LuisFelipe2204/camara-fenotipado/docs/FlowDiagram.png

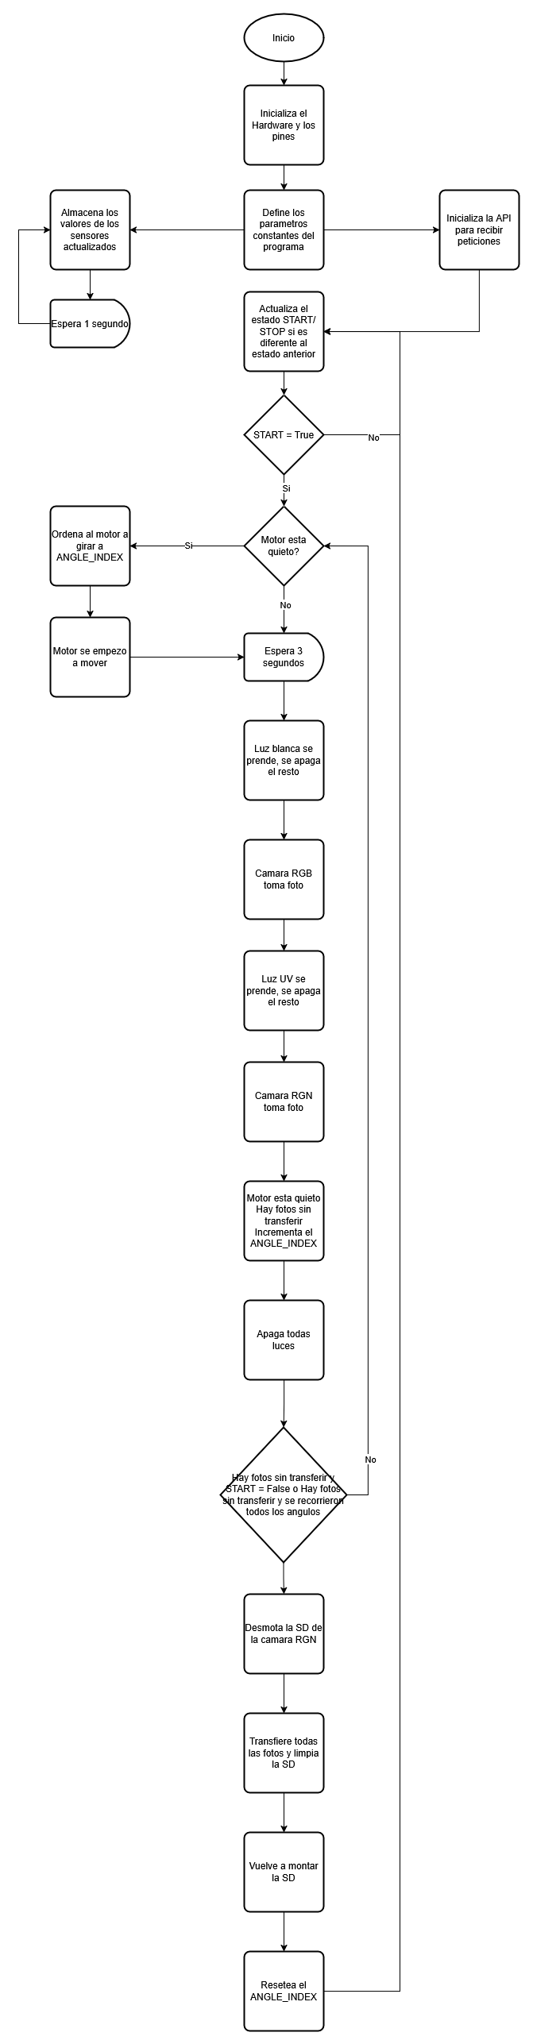
docs/FlowDiagram.png
