LuisFelipe2204/camara-fenotipado/(list of files, drawings)

Other design files:
docs/schema/Schema-V1.pdsprj
docs/schema/Schema.pdsprj
