LuisFelipe2204/camara-fenotipado/backend/modules/survey3.py

import logging
import shutil
import time
from os import listdir, path, remove

import digitalio

from utils import generate_photo_name, get_session_dirpath, safe_copy

logging.basicConfig(
    format=(
        "\033[90m%(asctime)s\033[0m "
        + "[\033[36m%(levelname)s\033[0m] "
        + "[\033[33m%(module)s::%(funcName)s\033[0m] "
        + "%(message)s"
    ),
    datefmt="%Y-%m-%d %H:%M:%S",
    level=logging.INFO,
    handlers=[logging.StreamHandler()],
)


class Pulse:
    DO_NOTHING = 0.001
    TAKE_PHOTO = 0.002
    TRANSFER = 0.0015


class Survey3:
    def __init__(self, pin: digitalio.DigitalInOut, cam_id: str, origin: str, dest: str):
        self.pin = pin
        self.origin = origin
        self.dest = dest
        self.id = cam_id
        self.pin.direction = digitalio.Direction.OUTPUT
        self.pin.value = False
        self.set_mount(True)

    def set_mount(self, to_mount: bool):
        # When to_mount is True, it ensures the SD becomes not accessible
        origin_exists = path.isdir(self.origin)
        # Mounted means the origin path should not be accessible
        if to_mount and origin_exists:
            logging.warning("Origin for camera %s accessible. Mounting back.", self.id)
            self.toggle_mount()
            return True
        # Dismounted means origin should exist
        if not to_mount and not origin_exists:
            logging.warning("Origin for camera %s not accessible. Dismounting.", self.id)
            self.toggle_mount()
            return True
        return False

    def pulse(self, pulse: float):
        self.pin.value = True
        time.sleep(pulse)
        self.pin.value = False
        time.sleep(0.1)

    def read(self):
        logging.info(f"Triggering {self.id}")
        self.pulse(Pulse.DO_NOTHING)
        self.pulse(Pulse.TAKE_PHOTO)
        self.pulse(Pulse.DO_NOTHING)
        # time.sleep(3)

    def toggle_mount(self):
        logging.info(f"Toggling mount for {self.id}")
        self.pulse(Pulse.DO_NOTHING)
        self.pulse(Pulse.TRANSFER)
        self.pulse(Pulse.DO_NOTHING)
        # time.sleep(3)

    def transfer_latest(self):
        if not path.exists(self.origin):
            logging.error("The directory %s does not exist.", self.origin)
            return False

        latest = None
        for file in listdir(self.origin):
            name = path.join(self.origin, file)
            if not path.isfile(name):
                continue
            if latest is None or path.getctime(name) > path.getctime(latest):
                latest = name
        if latest is None:
            logging.error("No files found in %s.", self.origin)
            return False

        safe_copy(
            latest, path.join(self.dest, generate_photo_name(self.id, time.time(), 0))
        )
        remove(latest)
        return True

    def transfer_n(self, n: int, session: int, timestamp: float = 0):
        if timestamp == 0:
            timestamp = time.time()

        if not path.exists(self.origin):
            logging.error("The directory %s does not exist.", self.origin)
            return False

        files = [
            f
            for f in listdir(self.origin)
            if f.lower().endswith((".jpg", ".jpeg", ".png"))
        ]
        files = sorted(
            files, key=lambda x: path.getctime(path.join(self.origin, x)), reverse=True
        )

        if len(files) < n:
            logging.error(
                "Not enough files found in %s. Expected %d, found %d",
                self.origin,
                n,
                len(files),
            )
            return False

        for i, file in enumerate(files[:n]):
            src = path.join(self.origin, file)
            dst = path.join(
                get_session_dirpath(self.dest, session),
                generate_photo_name(self.id, timestamp, i),
            )

            safe_copy(src, dst)
            remove(src)

        return True

    def clear_sd(self):
        if not path.exists(self.origin):
            logging.error("The directory %s does not exist.", self.origin)
            return False

        for file in listdir(self.origin):
            name = path.join(self.origin, file)
            if not path.isfile(name):
                continue

            try:
                remove(name)
            except Exception as e:
                logging.error("Failed to remove %s: %s", name, str(e))
        return True
