LuisFelipe2204/camara-fenotipado/(commit log)

2025-04-28 Circuit schematic
    [Schema.pdsprj]
2025-05-15 UV sensor tests & Dashboard API Added picture burst handling to Survey3
2025-05-16 Initial camera
2025-05-16 Redockerized backend & missing dependencies
    [api.py]
2025-05-20 Frontend, Undid backend docker & fix camera threads
    [api.py, main.py]
2025-05-23 Fixed camera delays & added credits
2025-05-23 Tagged wiring
    [Schema.pdsprj]
2025-05-26 Deleted backend Dockerfile & fixed exit
    [api.py]
2025-05-29 Switched to digitalio, commented functions, threaded sensors
2025-06-05 Updated schema with dvelas25/safety & separated delivery 1
    [Schema-V1.pdsprj, Schema.pdsprj]
2025-06-05 Fixed schema on README
    [Schema-V1.pdsprj]
2025-06-06 Flow diagram
2025-11-07 Partially adapted code to 2 cameras
2025-11-14 Error handling for missing components
    [main.py]
2025-11-28 Refactor frontend to Vite+TS
    [Schema-V1.pdsprj, Schema.pdsprj]
2025-12-03 Added display and direction switch
2025-12-03 Fix backwards progress logic
    [main.py]
2026-01-27 Revert "Comment main.py"
    This reverts commit 20912bd194f5bf2bf45b2d398233a5c36a6d1c3b.
    [main.py]
2026-02-25 Fix motor start & docker /media volume
    [data.py, main.py, survey3.py]
2026-02-26 Add turn off button & confirmation popups
2026-02-27 Make Survey3 cameras work in parallel
